Ricardo2301-kanima/Proyecto-TDA2005-con-modulo-bluetooth/esquematico/PCB.jpg

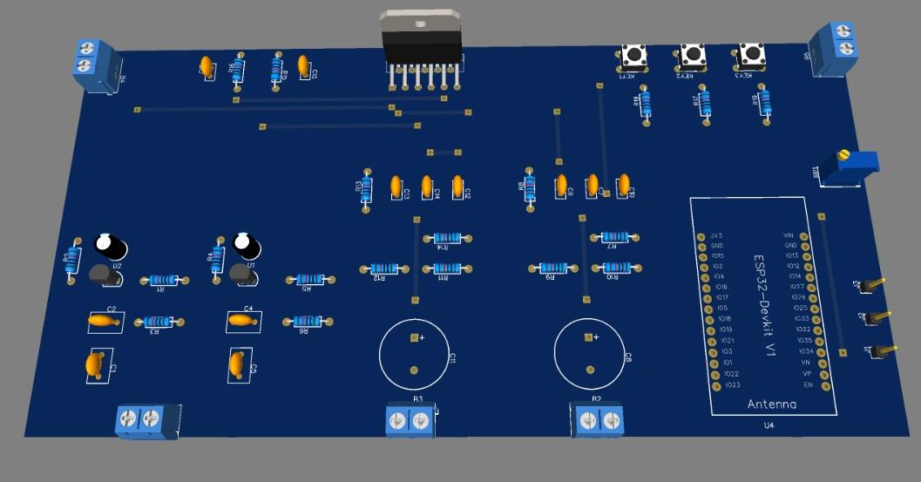
esquematico/PCB.jpg
