Ricardo2301-kanima/Proyecto-TDA2005-con-modulo-bluetooth/presentacion proyecto 2.pdf

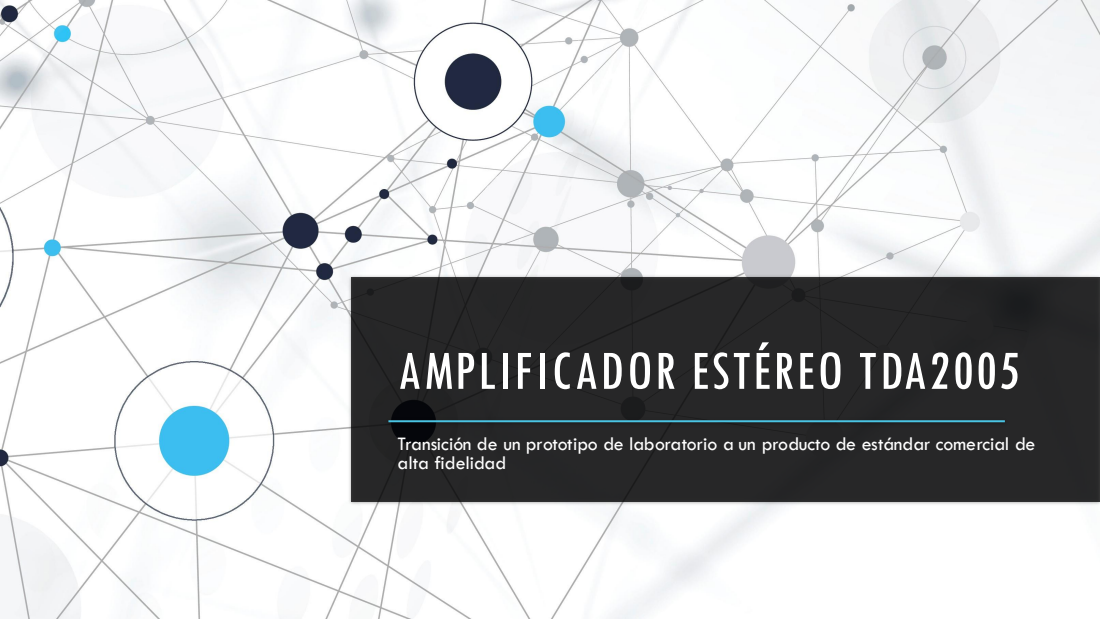
[picture p11: page 1]
AMPLIFICADOR ESTÉREO TDA2005

Transición de un prototipo de laboratorio a un producto de estándar comercial de
alta fidelidad

# ARQUITECTURA DEL SISTEMA Y CADENA DE SEÑAL

## Digital

RX Bluetooth - I2S/DMA

## Acondicionamiento

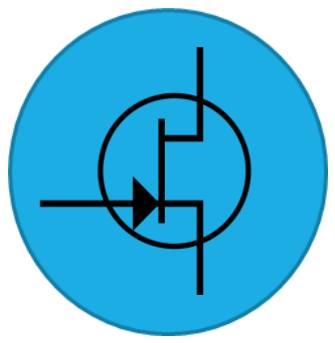
[picture p12: figure]

Preamplificador JFET

## Potencia

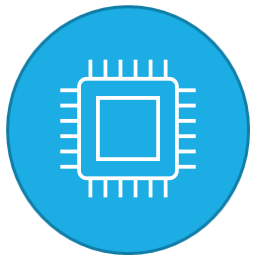
[picture p13: figure]

TDA2005 en estéreo
estricto

## Salida

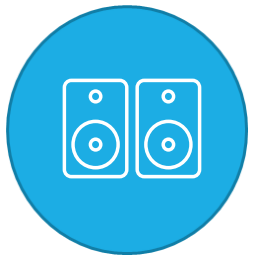
[picture p14: figure]

Altavoces 10w + 10w

# SELECCIÓN DE COMPONENTES Y PRESUPUESTO GASTADO

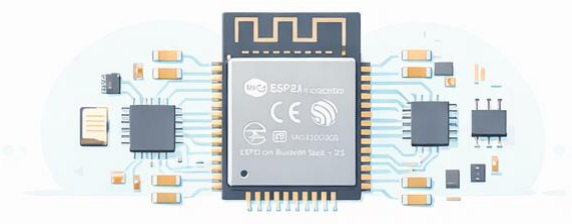
[picture p15: figure]

- Procesamiento
Modulo ESP32 con Bluetooth Stack + I2S ($16.000) DAC ($77.000)
- Acondicionamiento
Transistor J201 y Resistencias ($12.000)
- Potencia
Circuito integrado TDA2005 Adaptadores dc-dc ($40.000)
- Infraestructura
Placa PCB ($80.000)
Carcasa ($40.000)
Fuente conmutada 24v 150w ($61.000) Parlante y otros componentes ($36.000)

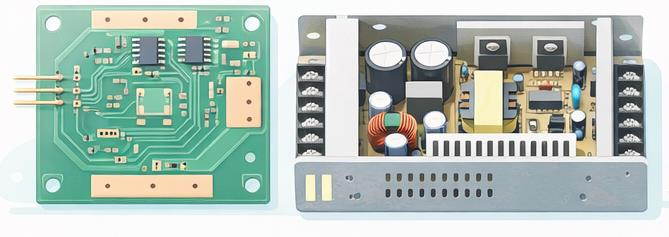
[picture p16: figure]

El total es de: $362.000

# ETAPA PREAMPLIFICADOR

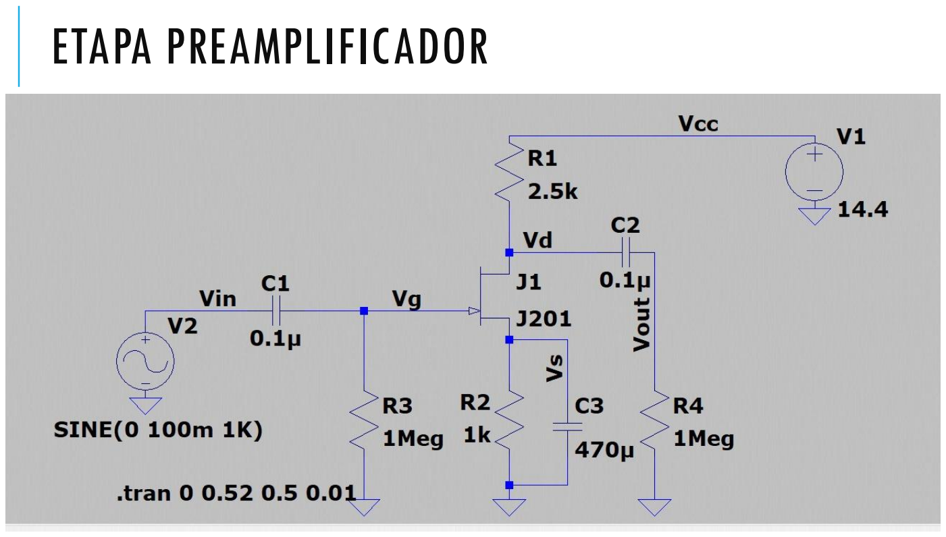
[picture p17: page 4]

# ETAPA TDA2005

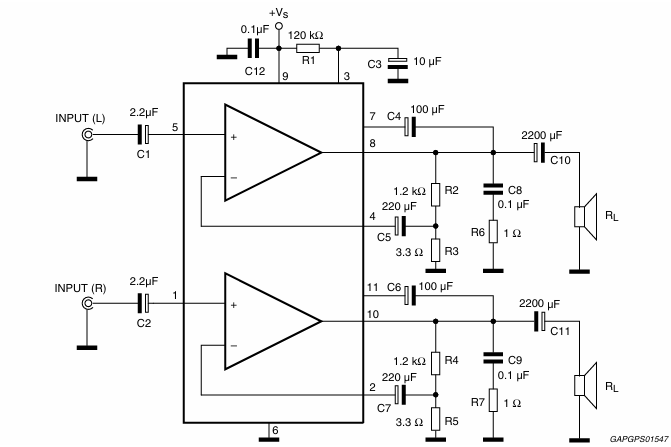
[picture p18: figure]

# FIRMWARE

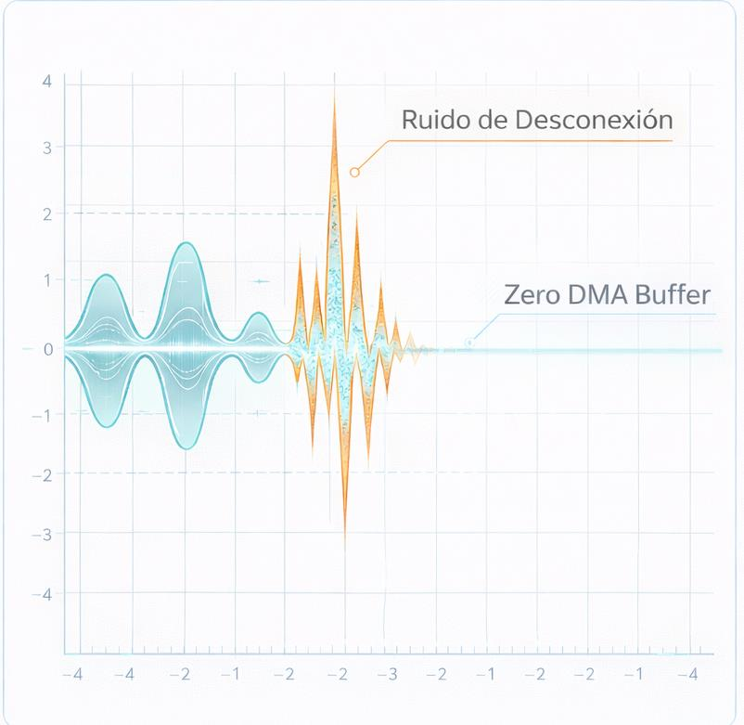
[picture p19: figure]

- Protocolo I2S con DMA
Flujo directo a memoria; evita sobrecarga de CPU.
- Reloj de Alta Fidelidad
Salida a 16 bits y 44.1 kHz activo para máxima precisión
- Supresión de Transitorios
Gestión de silencio mediante i2s_zero_dma_buffer ante desconexión

# ANÁLISIS DE DISEÑO ANALÓGICO

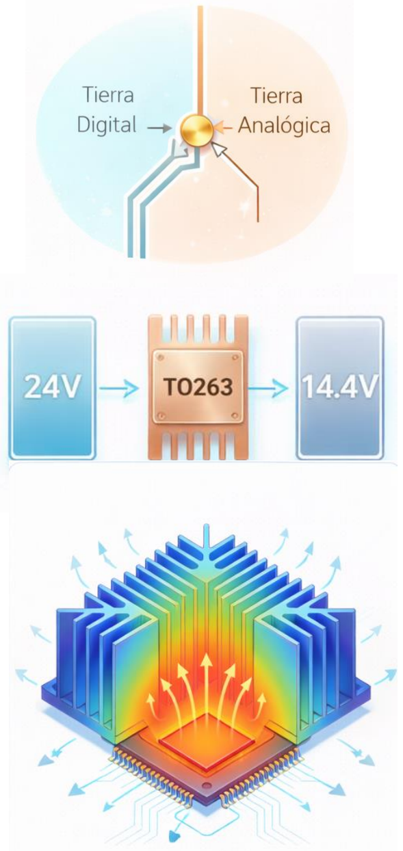
[picture p20: figure]

- Ruteo
Topología de tierra en estrella:
Separación analógica y digital para suprimir bucles
- Regulación de voltaje
Step-down TO263: reducción del bus principal de 24V a 14.4V estables.
- Gestión Térmica
Acoplamiento físico: Disipación calculada para el TDA2005, previniendo el apagado térmico hasta 3.5A

# CIRCUITO EN PROTEUS

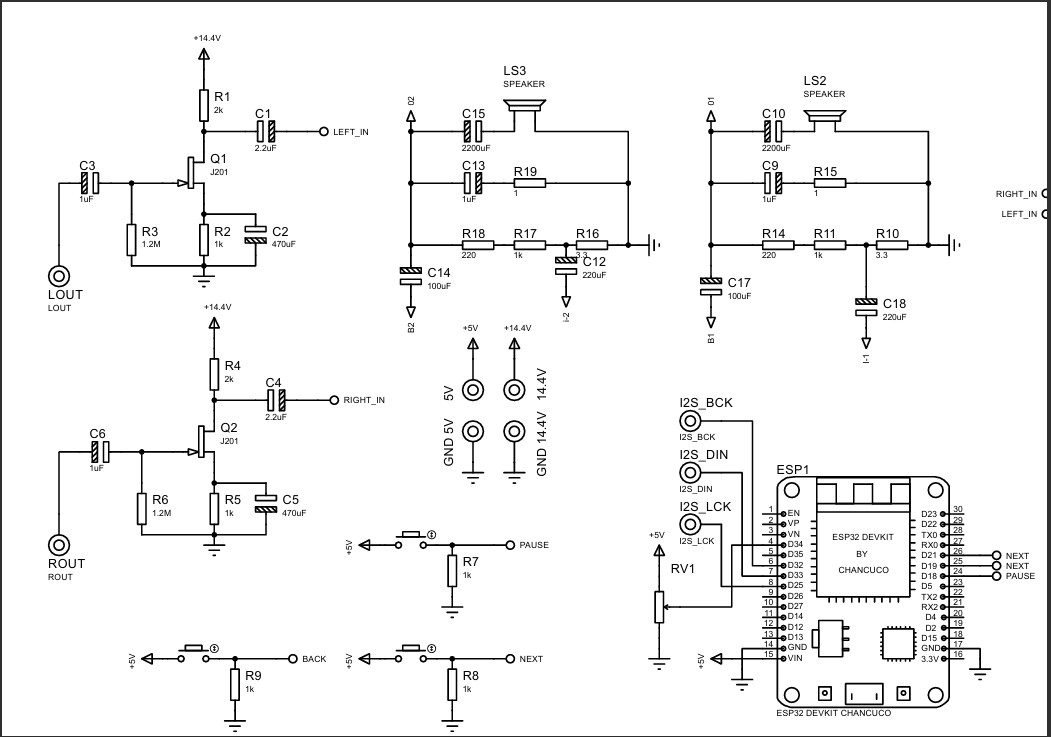
[picture p21: figure]

# IMPLEMENTACIÓN

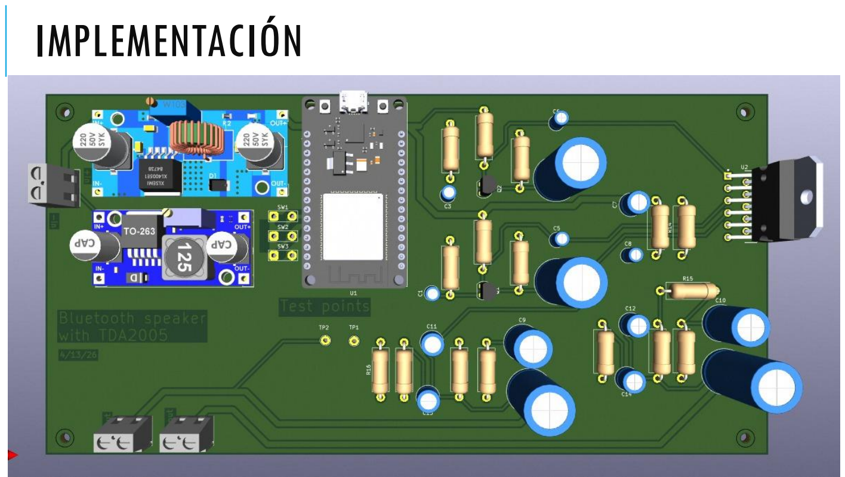
[picture p22: page 9]
