Ricardo2301-kanima/Proyecto-TDA2005-con-modulo-bluetooth/esquematico/esquematico.jpg

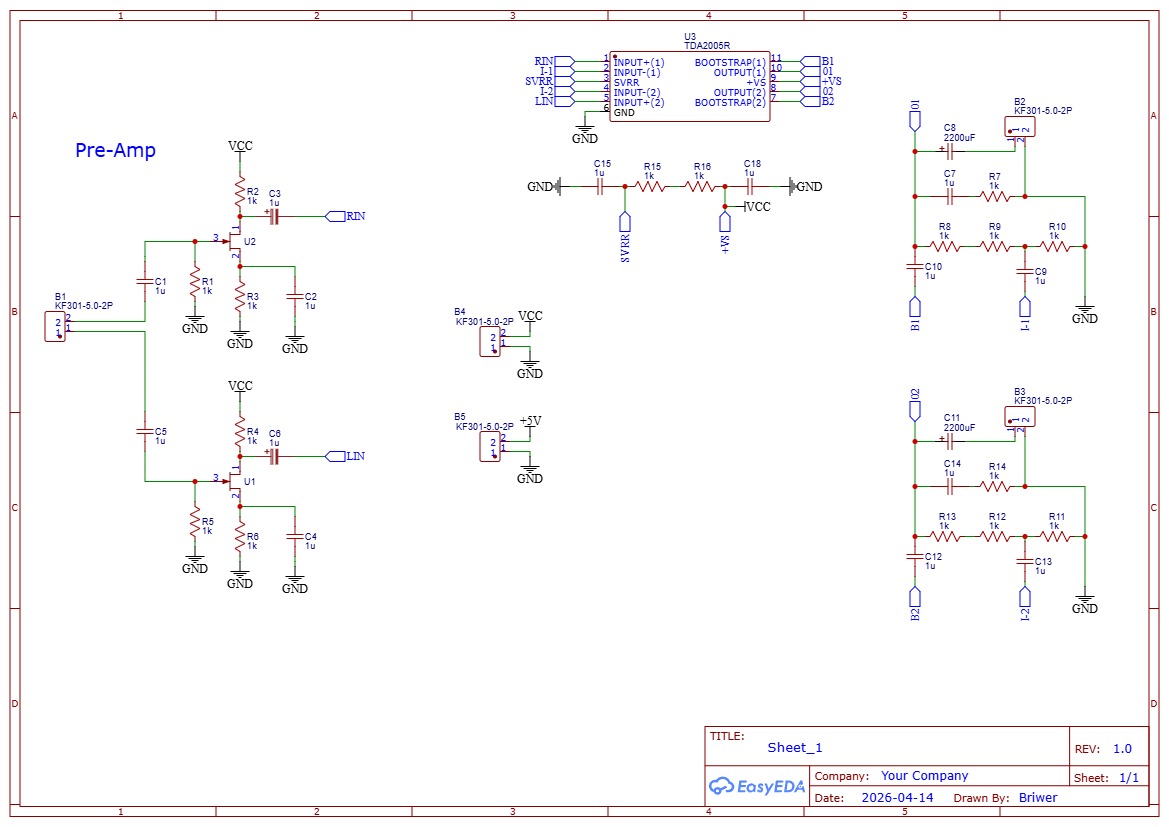
esquematico/esquematico.jpg
