Ricardo2301-kanima/Proyecto-TDA2005-con-modulo-bluetooth/esquematico/lineas de cobre.jpg

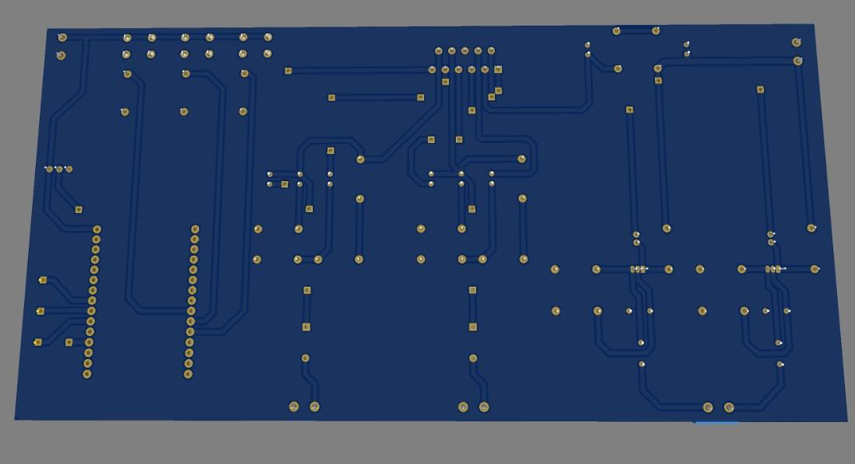
esquematico/lineas de cobre.jpg
