Ricardo2301-kanima/Proyecto-TDA2005-con-modulo-bluetooth/(list of files, drawings)

Other design files:
proteus.pdsprj
